papcodientu/Chameleon-Lamp/PCB/Schematic.pdf

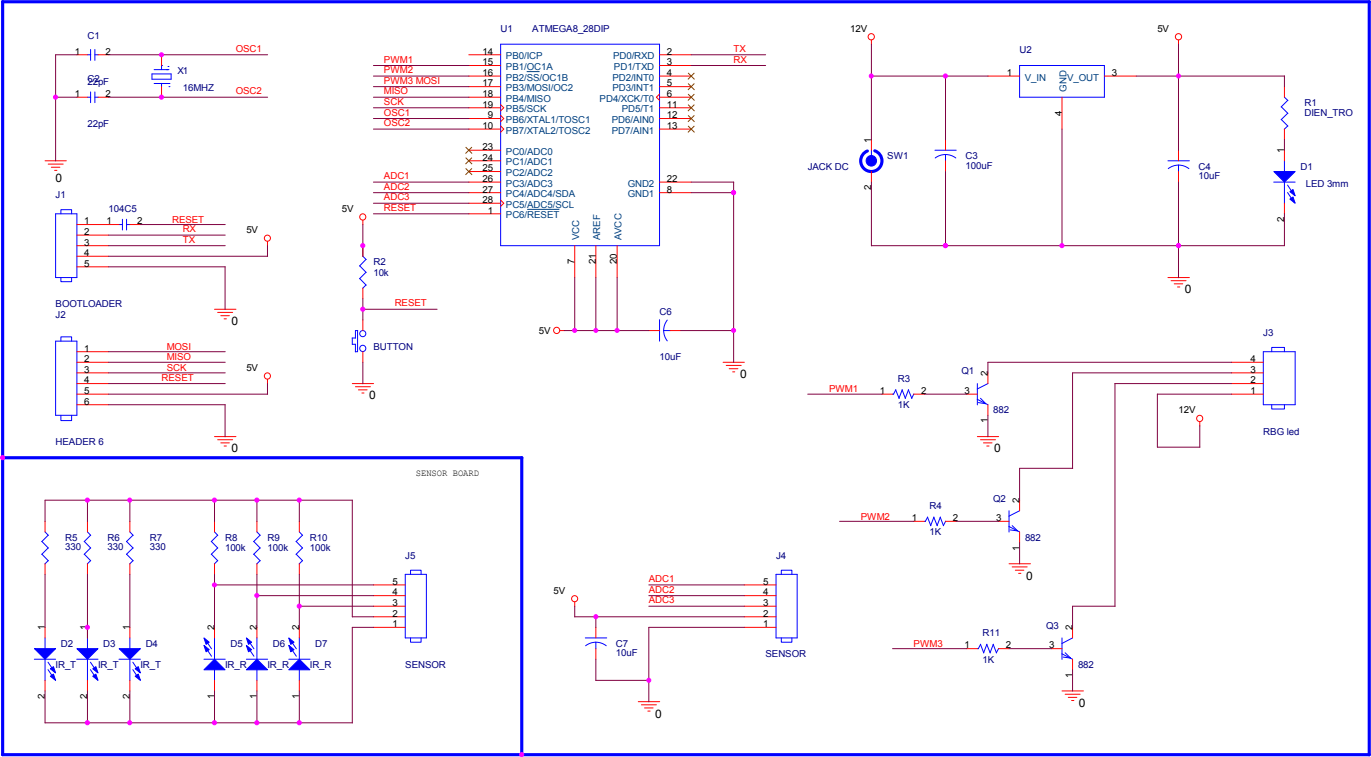
[picture p5: page 1]
