papcodientu/Chameleon-Lamp/PCB/MAINBOARD/MACHV3.pdf

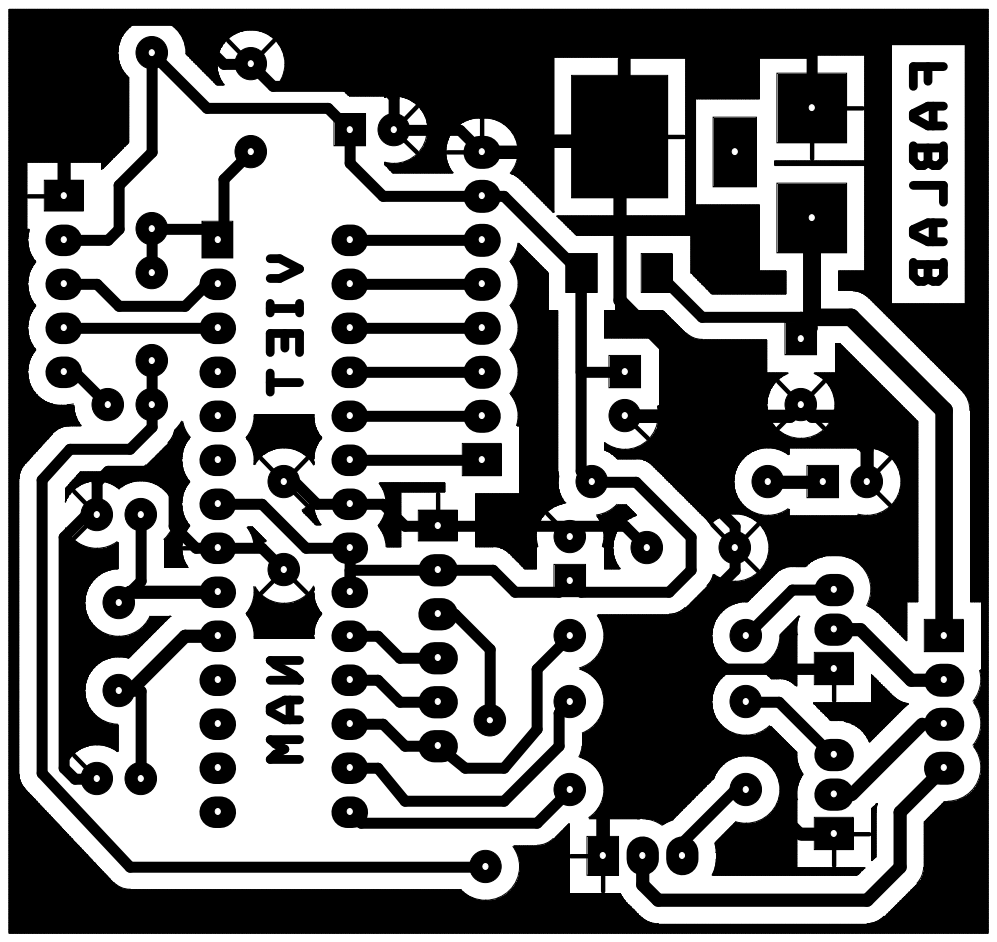
[picture p6: page 1]
