papcodientu/Chameleon-Lamp/PCB/MAINBOARD/MACHV3sst.pdf

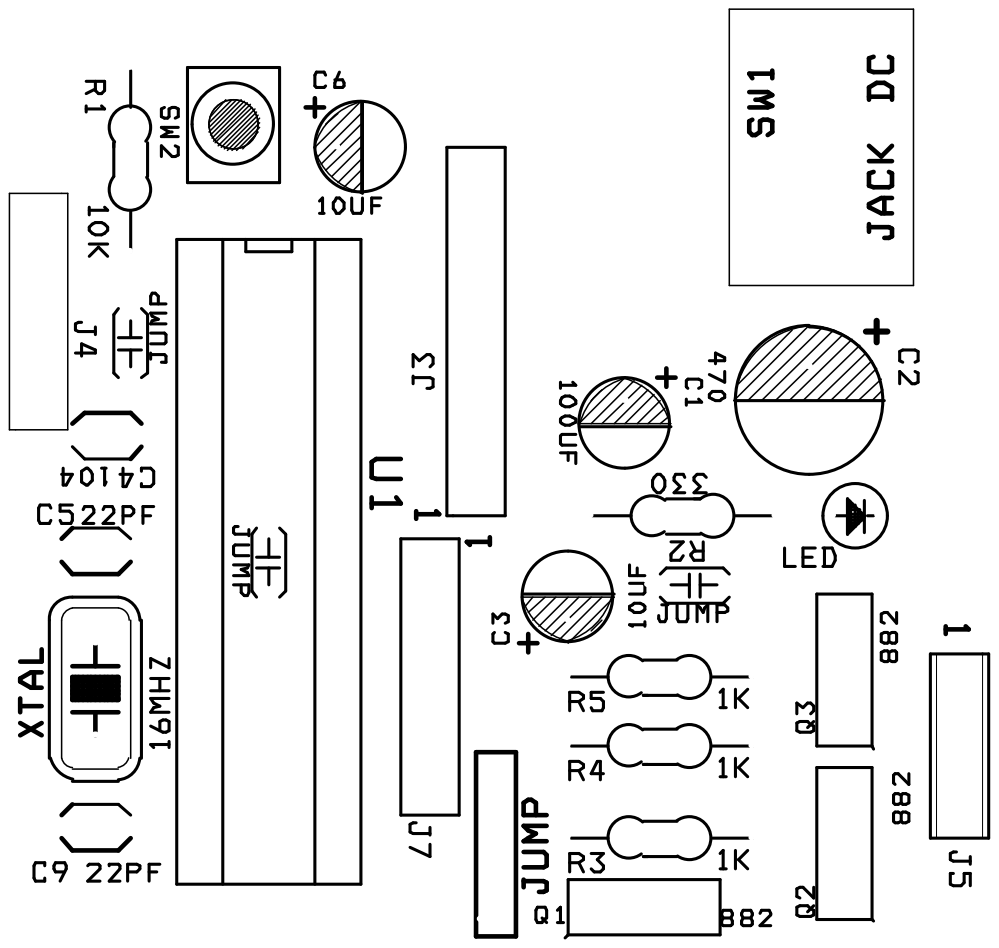
[picture p7: page 1]
