papcodientu/Chameleon-Lamp/PCB/SENSOR/SENSOR.pdf

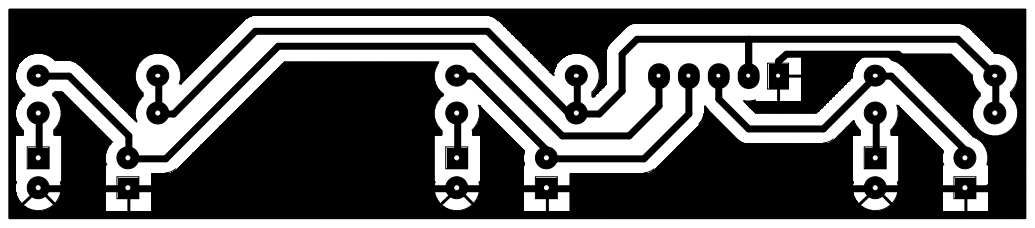
[picture p8: page 1]
