papcodientu/Chameleon-Lamp/(commit log)

2015-05-28 Added PCB design.
2015-06-11 Added schematic file.
